Loyola-Future-Engineers/Ion-Thruster-Type-EDH/cad/README.md

# 3-D part models

**Design proposal: not printed, machined, assembled or tested.** Every part is generated
parametrically by `cad/build.py` (manifold3d + trimesh). All dimensions are in millimetres.
The geometry follows the common-supply recommendation in
[`docs/recommendations.md`](../docs/recommendations.md): 40 mm insulating bore, 16 axial
stainless needles on a 30 mm brass ring, 30 mm aluminum tube collectors, gap d = 25 mm from the
needle tips to the collector, and inter-stage spacing s = 75 mm (3d, from the space-charge results).

| Output | What it is |
|---|---|
| `stl/*.stl` | One watertight STL per unique part (13 parts, plus a tie rod per variant) |
| `assembly_2stage.stl`, `assembly_3stage.stl` | Full assemblies on the thrust-test stand |
| `viewer_2stage.html`, `viewer_3stage.html` | Interactive 3-D viewers. Open in a browser and click the legend to hide parts. Needs internet for the Plotly script. |
| `bom_2stage.csv`, `bom_3stage.csv` | Bill of materials: quantity, material, process, envelope, and mass computed from the mesh volume |
| `interference_*.txt` | Pairwise overlap check of every placed part (result: none) |
| `../diagrams/cad_*stage_section.png`, `cad_*stage_exterior.png` | Section through the axis, and exterior render |

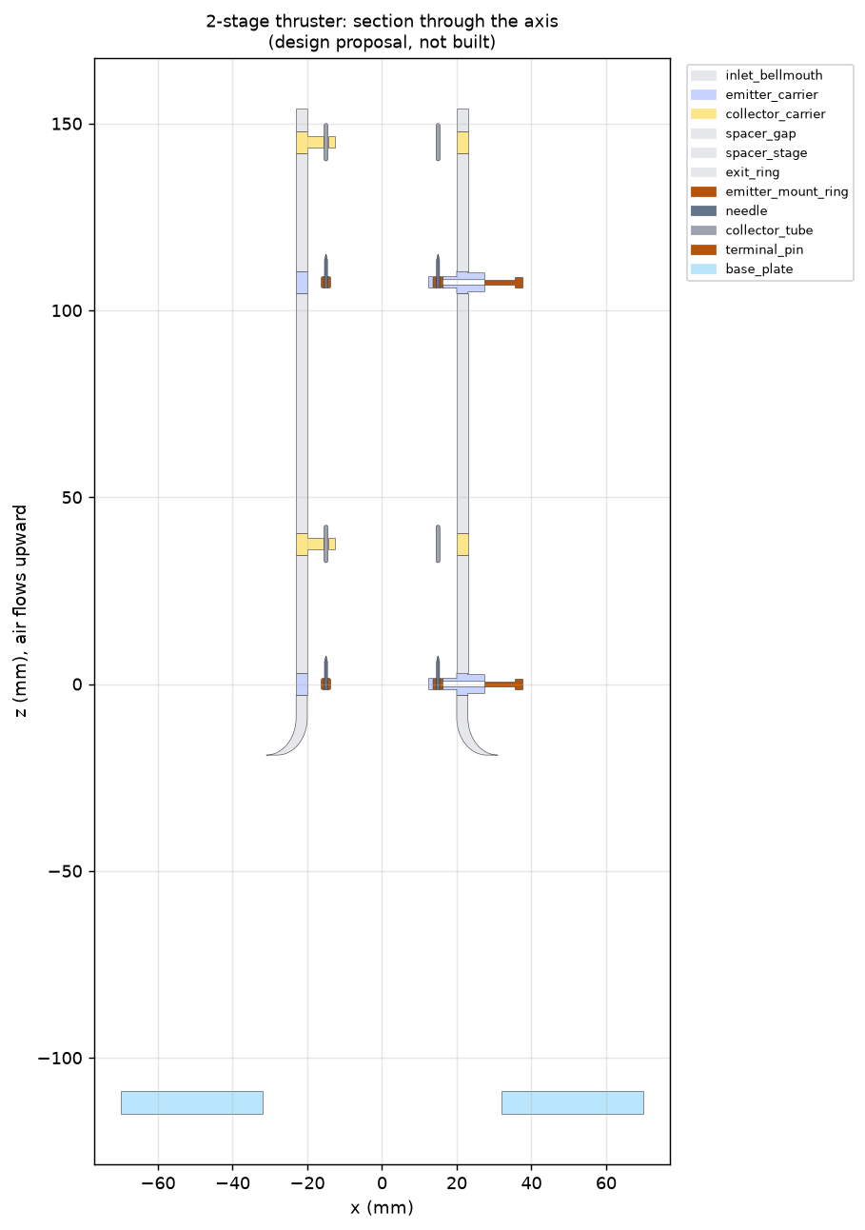
[picture p11: diagrams/cad_2stage_section.png]
section


## Parts

| Part | Qty (2-stage / 3-stage) | Material | Role |
|---|---|---|---|
| `inlet_bellmouth` | 1 / 1 | PETG or ASA (printed) | Rounded inlet, which reduces entry loss. Carries the bottom tie-rod lugs. |
| `emitter_carrier` | 2 / 3 | PETG or ASA | Bore ring with 3 spokes holding the emitter ring. HV wire channel through the 0° spoke to a boss. |
| `emitter_mount_ring` | 2 / 3 | Brass | 30 mm ring, 2.5 × 3 mm section, 16 needle holes; laser/waterjet-cut from 3 mm sheet |
| `needle` | 32 / 48 | Stainless steel (insect pins, bought) | Ø0.5–0.8 mm, 6 mm exposed, about 0.05 mm tip, pointing downstream |
| `collector_carrier` | 2 / 3 | PETG or ASA | Bore ring with 3 spokes gripping the collector tube. Spokes are rotated 60° from the emitter spokes to lengthen surface creepage paths. |
| `collector_tube` | 2 / 3 | Aluminum 6061 | Ø30 mm mean, 1 mm wall, 10 mm long, rounded edges |
| `spacer_gap` | 2 / 3 | PETG or ASA | 31.5 mm bore spacer that sets d. Print several lengths to test other gaps. |
| `spacer_stage` | 1 / 2 | PETG or ASA | 64 mm bore spacer that sets s |
| `exit_ring` | 1 / 1 | PETG or ASA | Top ring with tie-rod lugs |
| `terminal_pin` | 4 / 6 | Brass | HV feed (emitters) and ground return (collectors), on the carrier bosses |
| `tie_rod_*stage` | 3 / 3 | Nylon M3 | Clamp the stack. Insulating. |
| `standoff` | 3 / 3 | PTFE or acetal | 100 mm insulating legs (see `experiments/test_plan.md`) |
| `base_plate` | 1 / 1 | Polycarbonate or acetal | Sits on the balance. A 64 mm hole lets air into the inlet. |

Length and mass (thruster without stand): **173 mm and about 129 g (2-stage); 281 mm and about 202 g
(3-stage)**. Most of the mass is the printed housing; a thinner wall or lighter infill would reduce it.

## Design notes and open issues
- **Creepage:** the surface path from emitter to collector along the printed spokes and bore is
  about 50 mm with the 60° spoke offset, about 2× the 25 mm air gap. That is at the low end of the
  2–3× guideline. If surface tracking or charging shows up, add ribs or grooves to the bore between carriers.
- **Collector section:** the simulations used a 4 mm-thick rounded collector. The CAD tube has a
  1 mm wall, which is lighter and blocks less air, but its sharper edges could start a reverse corona at
  high voltage. Round the edges to at least 0.5 mm radius.
- **HV wiring:** a short bare Ø0.8 mm copper wire runs through the spoke channel (Ø1.4 mm) from the
  terminal pin to the brass ring. It is inside the device at emitter potential, so it needs no
  insulation. The insulated ≥ 30 kV silicone lead from the supply attaches to the terminal pin outside.
- **Needle retention:** drill the holes about 0.02 mm larger than the pins and fix the pins with
  a drop of adhesive. Do not solder stainless.
- **Bore wall:** the space-charge model treats the printed bore as a fully charged-up insulator.
  The first minutes of operation, while it charges, will behave differently.

## Rebuild / change a parameter
```bash
.venv/bin/python cad/build.py     # edit the Cfg dataclass (gap, spacing, pins, bore...) first
```
