Loyola-Future-Engineers/Ion-Thruster-Type-EDH/charts/B5_breakdown_margin.png

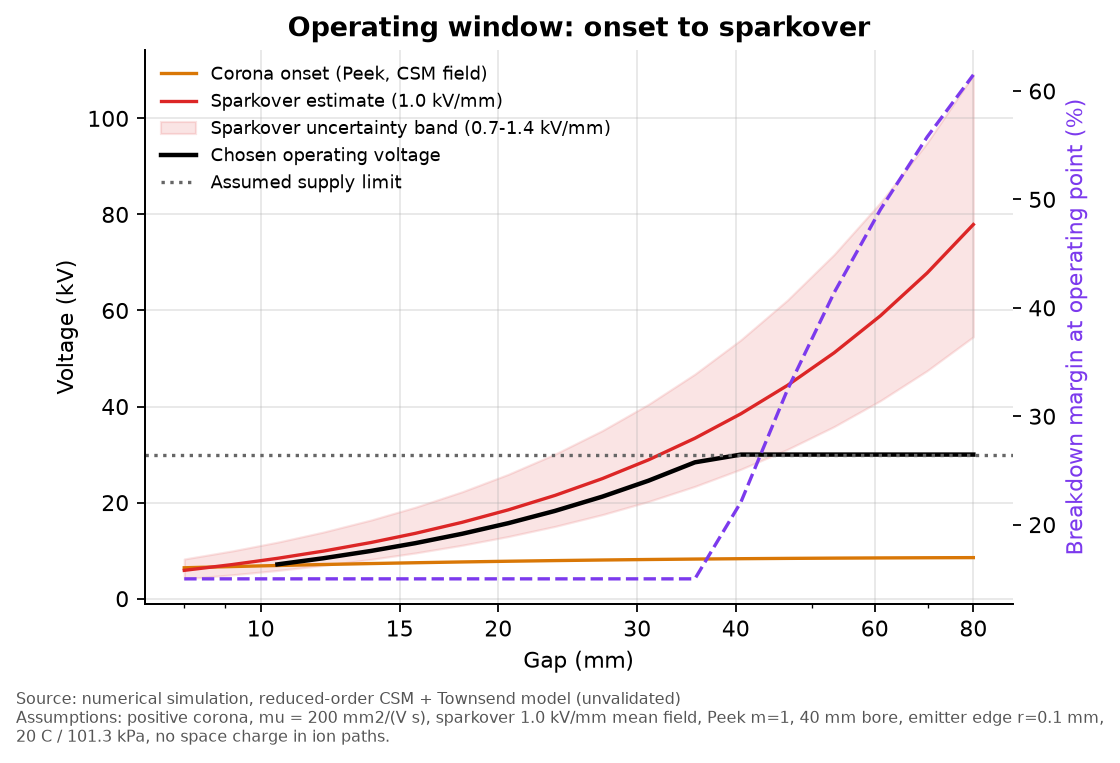
charts/B5_breakdown_margin.png
