Loyola-Future-Engineers/Ion-Thruster-Type-EDH/charts/B6_gap_pattern_comparison.png

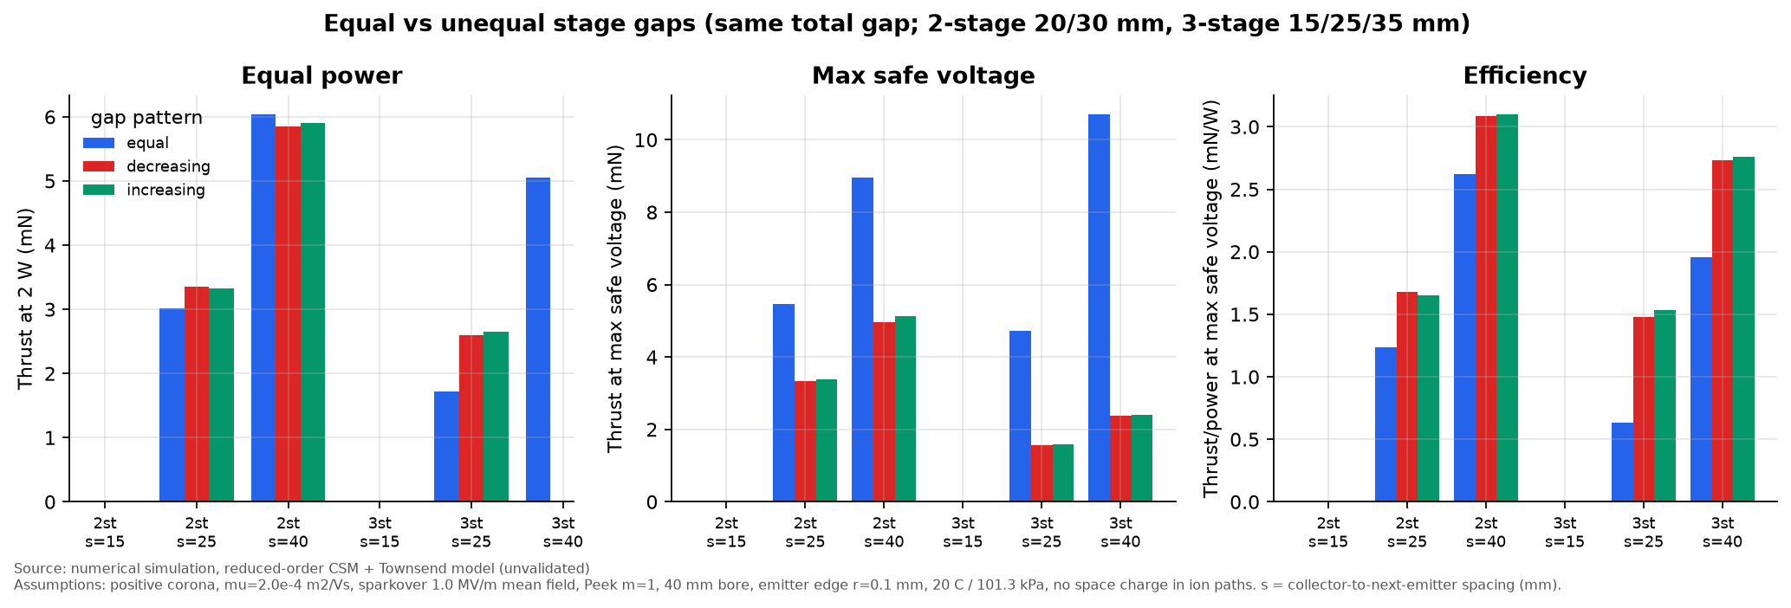
charts/B6_gap_pattern_comparison.png
