Loyola-Future-Engineers/Ion-Thruster-Type-EDH/charts/B6_gap_patterns_common_supply.png

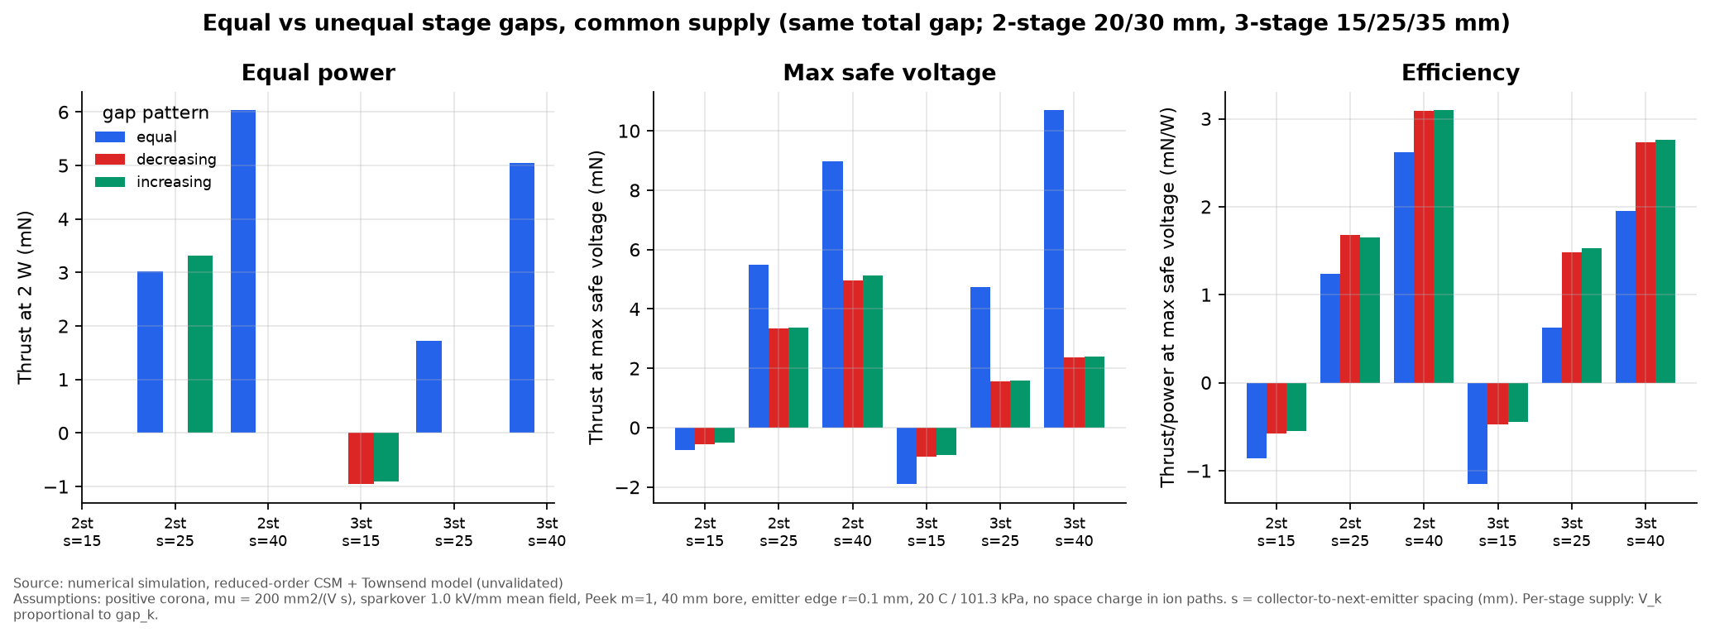
charts/B6_gap_patterns_common_supply.png
