Loyola-Future-Engineers/Ion-Thruster-Type-EDH/charts/B7_backflow_by_stage.png

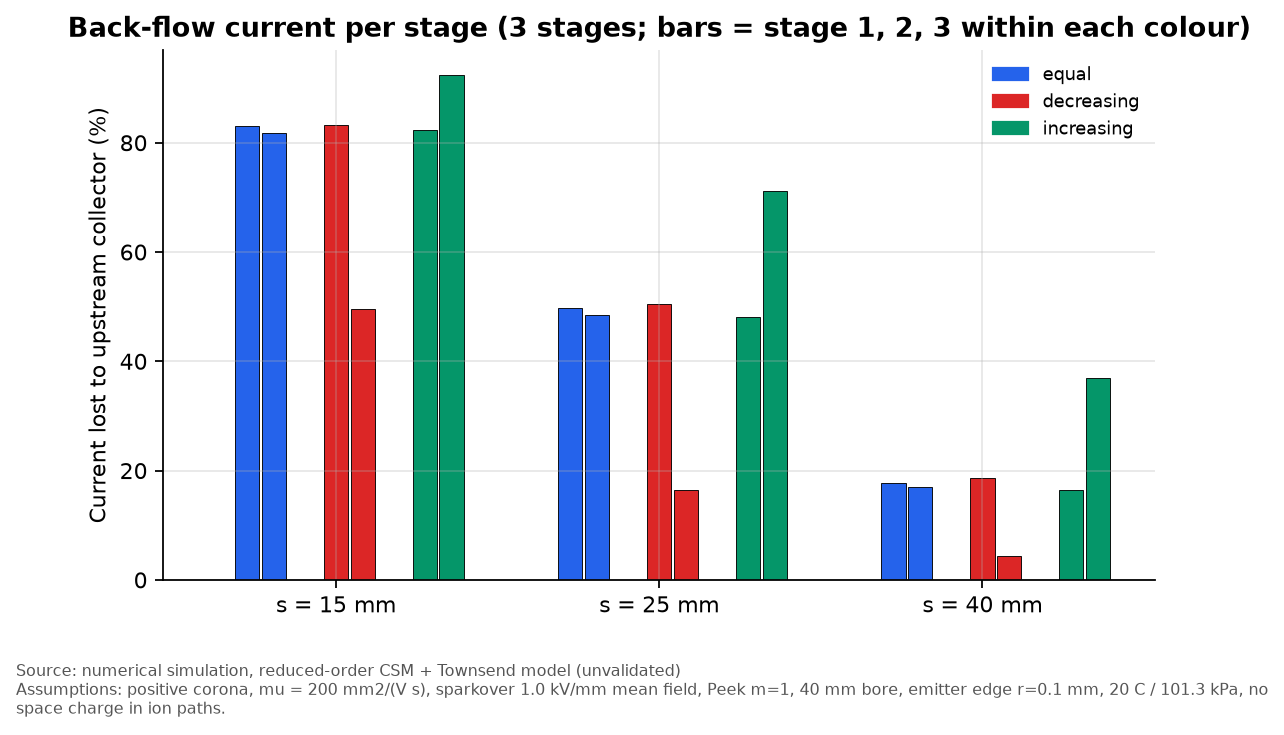
charts/B7_backflow_by_stage.png
