Loyola-Future-Engineers/Ion-Thruster-Type-EDH/charts/B9_independent_gap_search.png

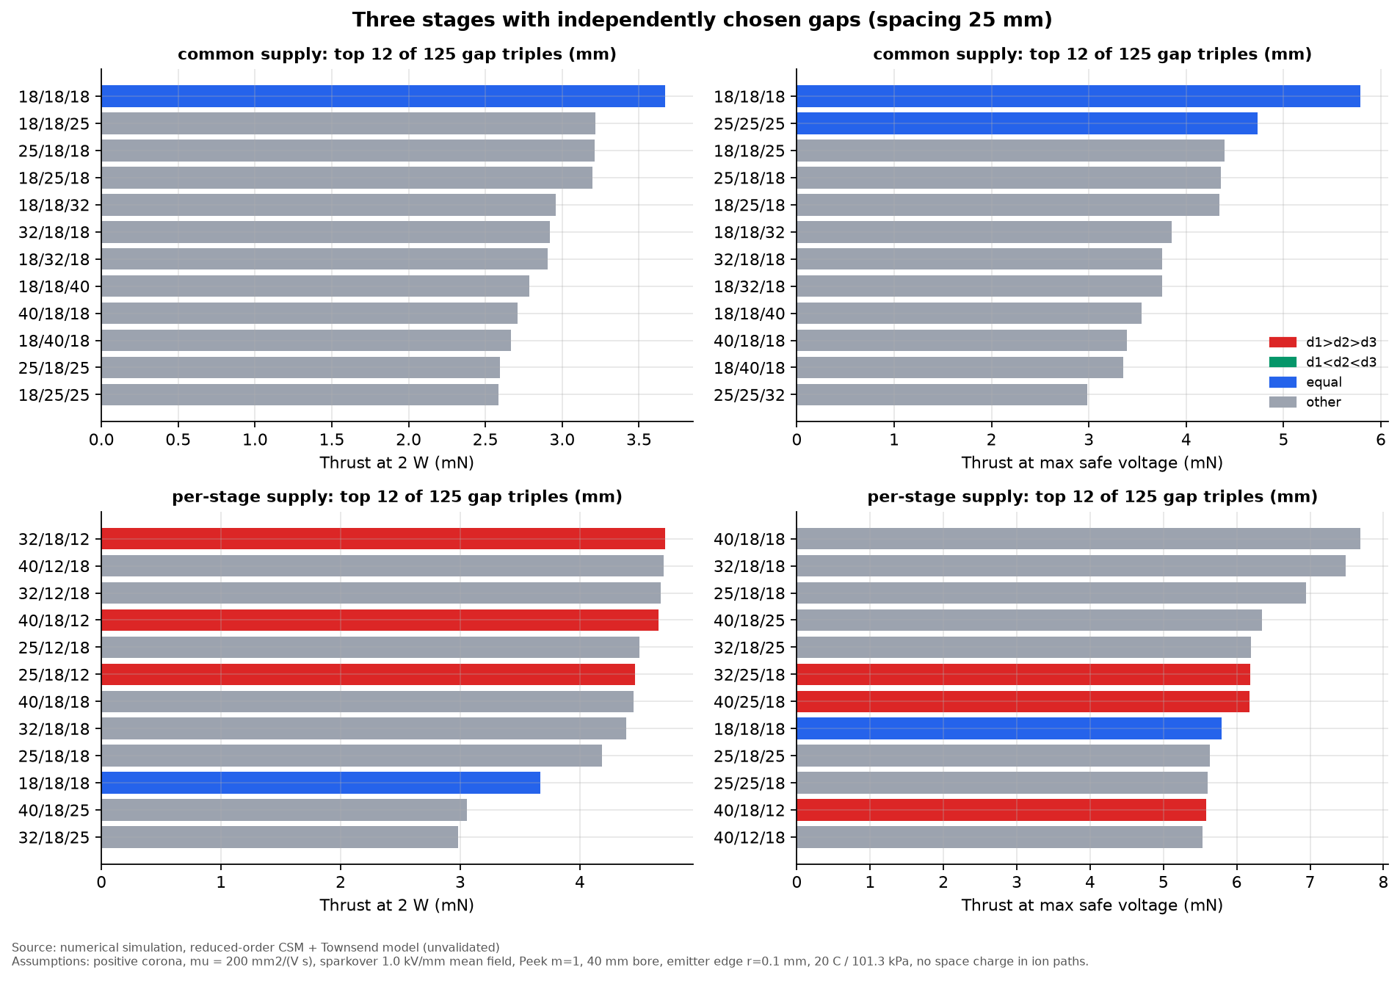
charts/B9_independent_gap_search.png
