Loyola-Future-Engineers/Ion-Thruster-Type-EDH/charts/F2_stage_count_equal_power.png

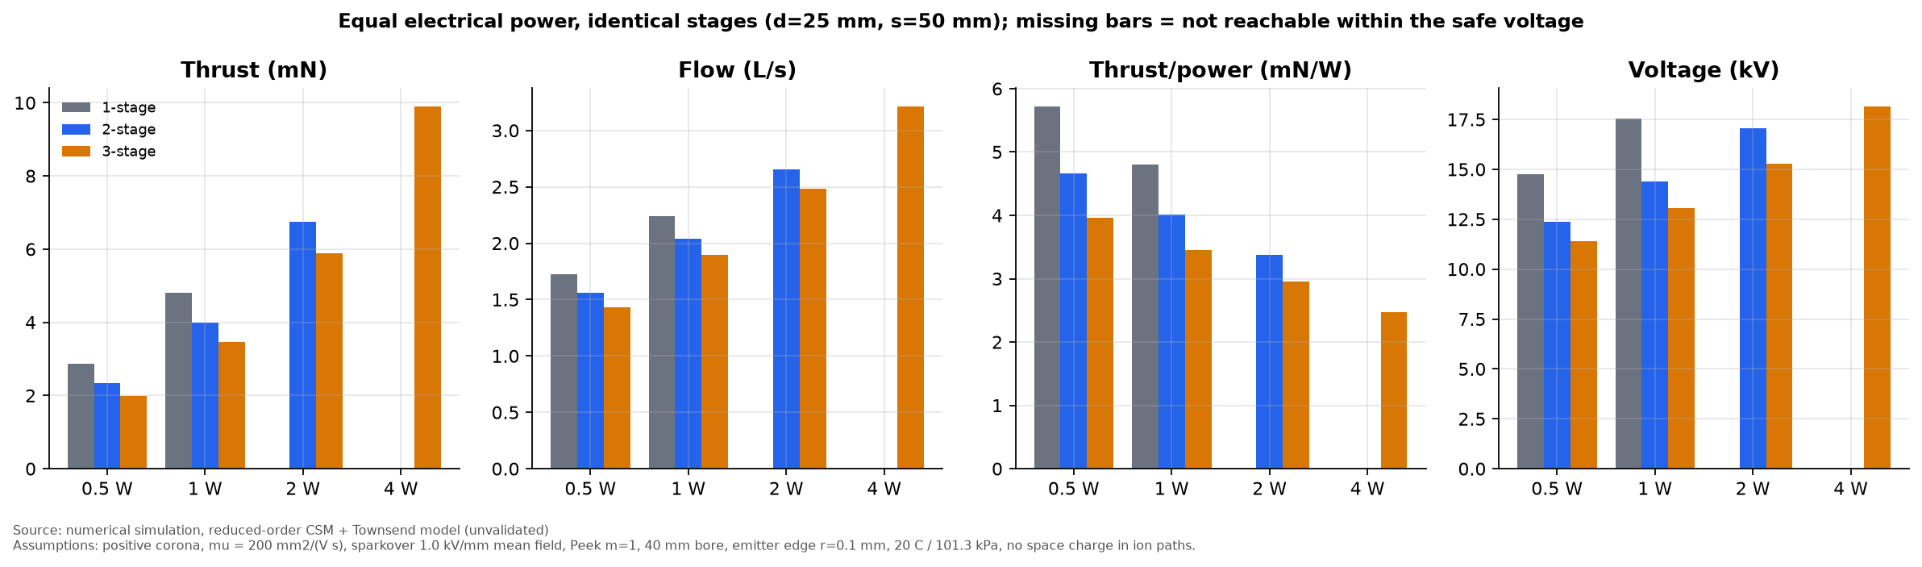
charts/F2_stage_count_equal_power.png
