Loyola-Future-Engineers/Ion-Thruster-Type-EDH/charts/F3_stage_count_vs_power.png

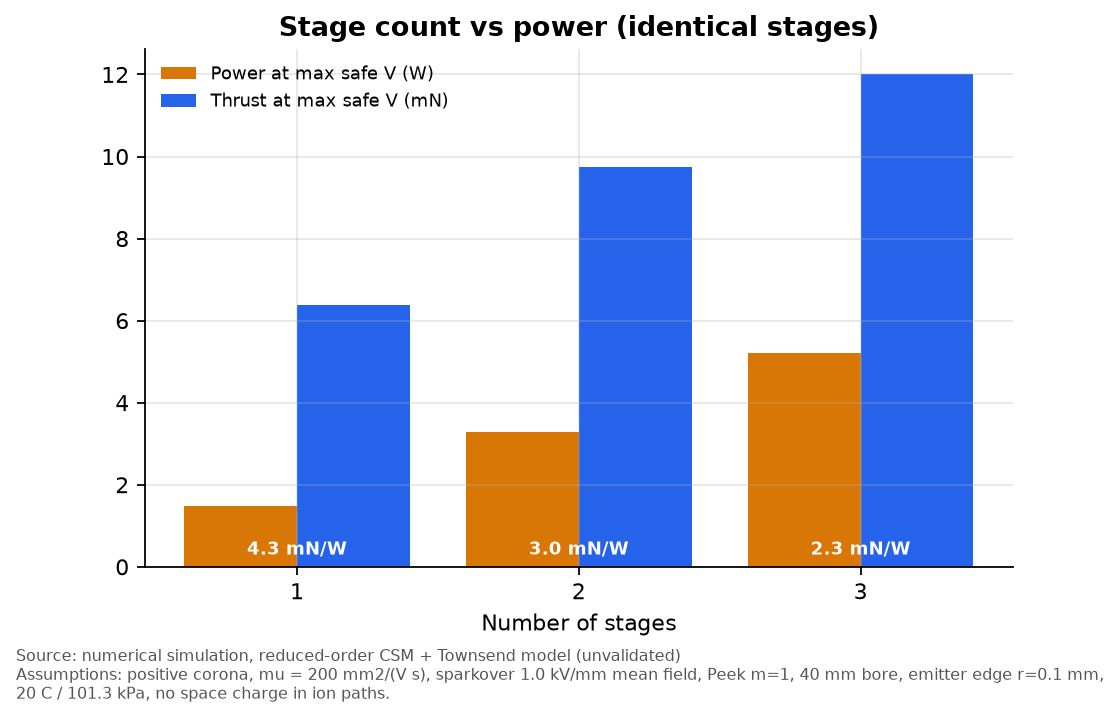
charts/F3_stage_count_vs_power.png
