Loyola-Future-Engineers/Ion-Thruster-Type-EDH/diagrams/cad_3stage_exterior.png

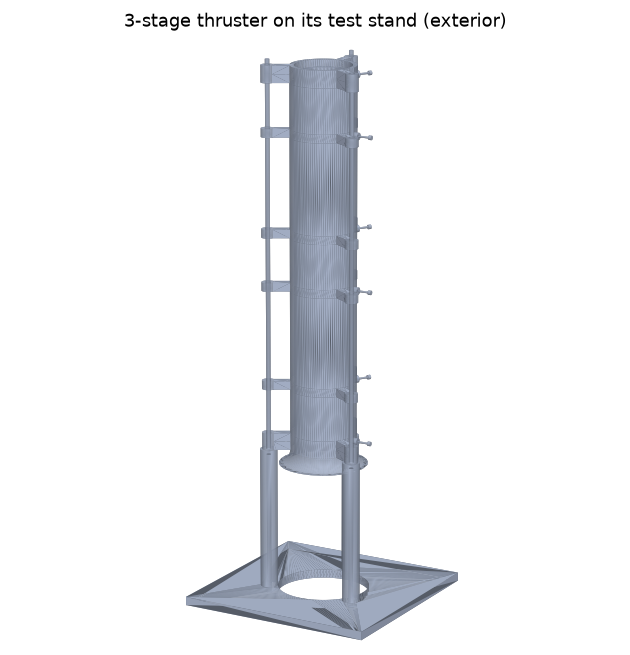
diagrams/cad_3stage_exterior.png
