Loyola-Future-Engineers/Ion-Thruster-Type-EDH/diagrams/cad_3stage_section.png

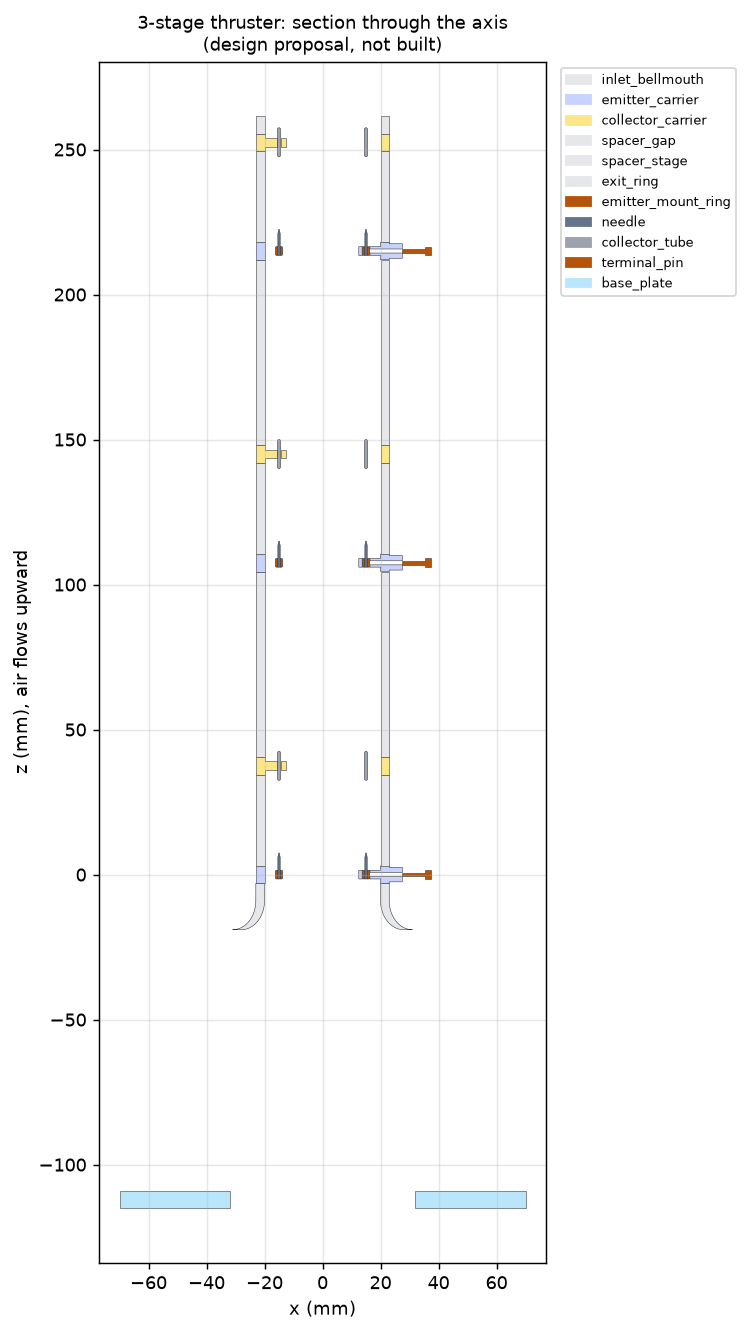
diagrams/cad_3stage_section.png
