Loyola-Future-Engineers/Ion-Thruster-Type-EDH/diagrams/pin_orientations.png

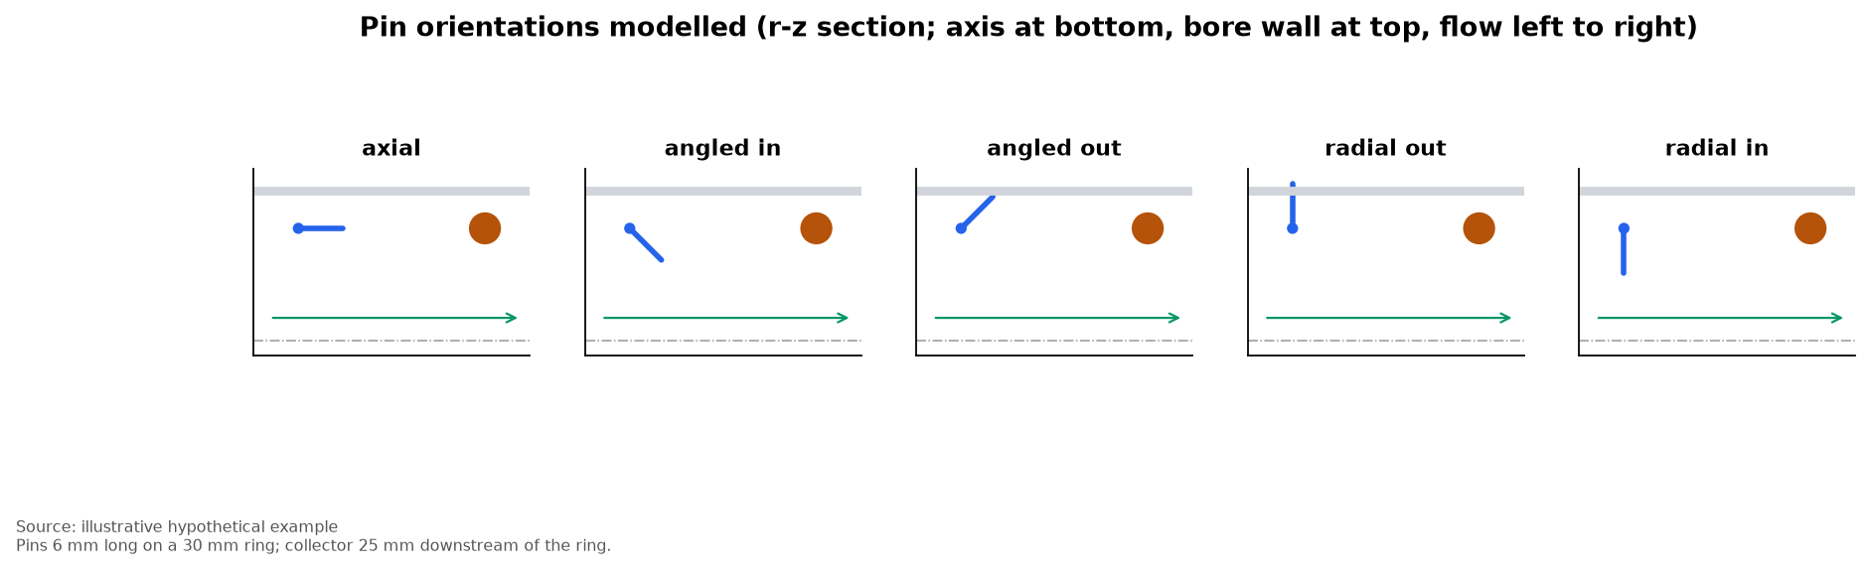
diagrams/pin_orientations.png
