Loyola-Future-Engineers/Ion-Thruster-Type-EDH/diagrams/pin_ring_front.png

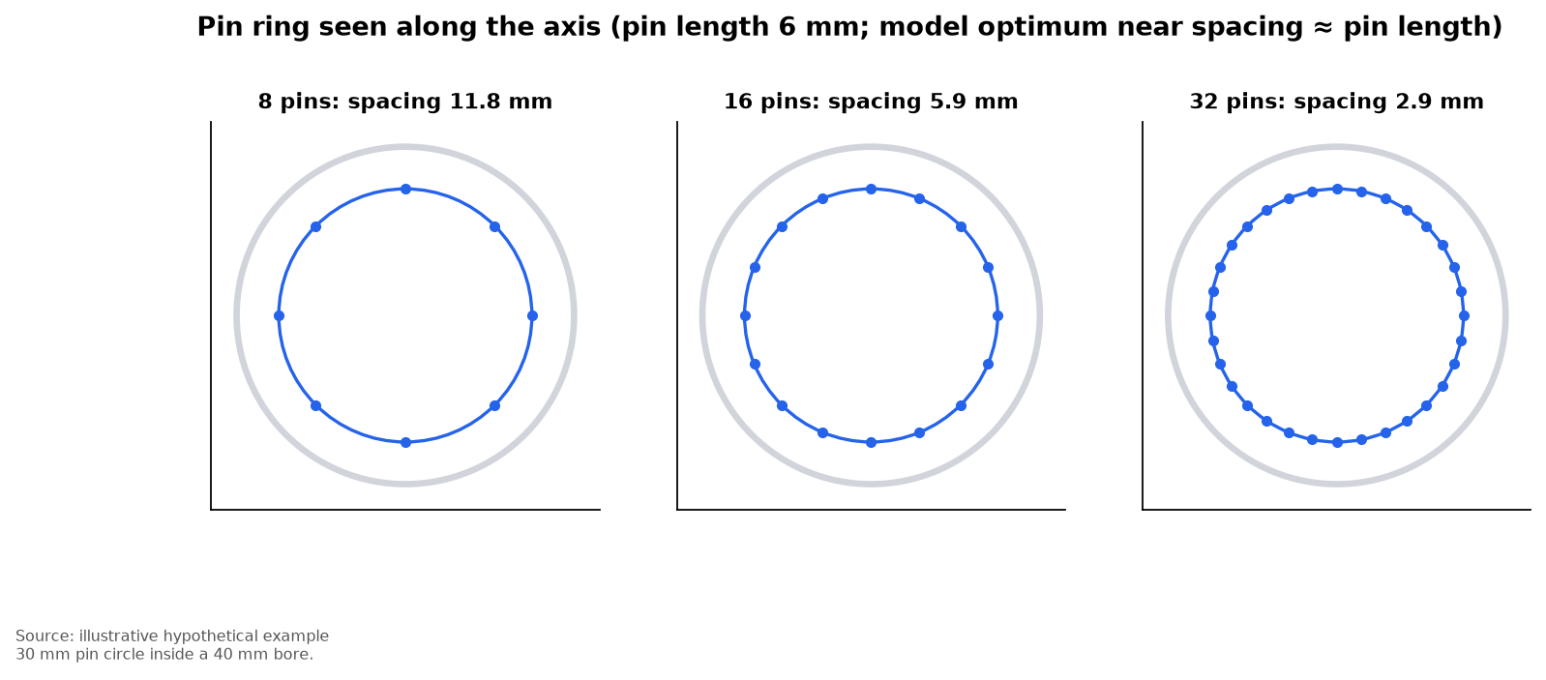
diagrams/pin_ring_front.png
