Loyola-Future-Engineers/Ion-Thruster-Type-EDH/diagrams/three_stage_section.png

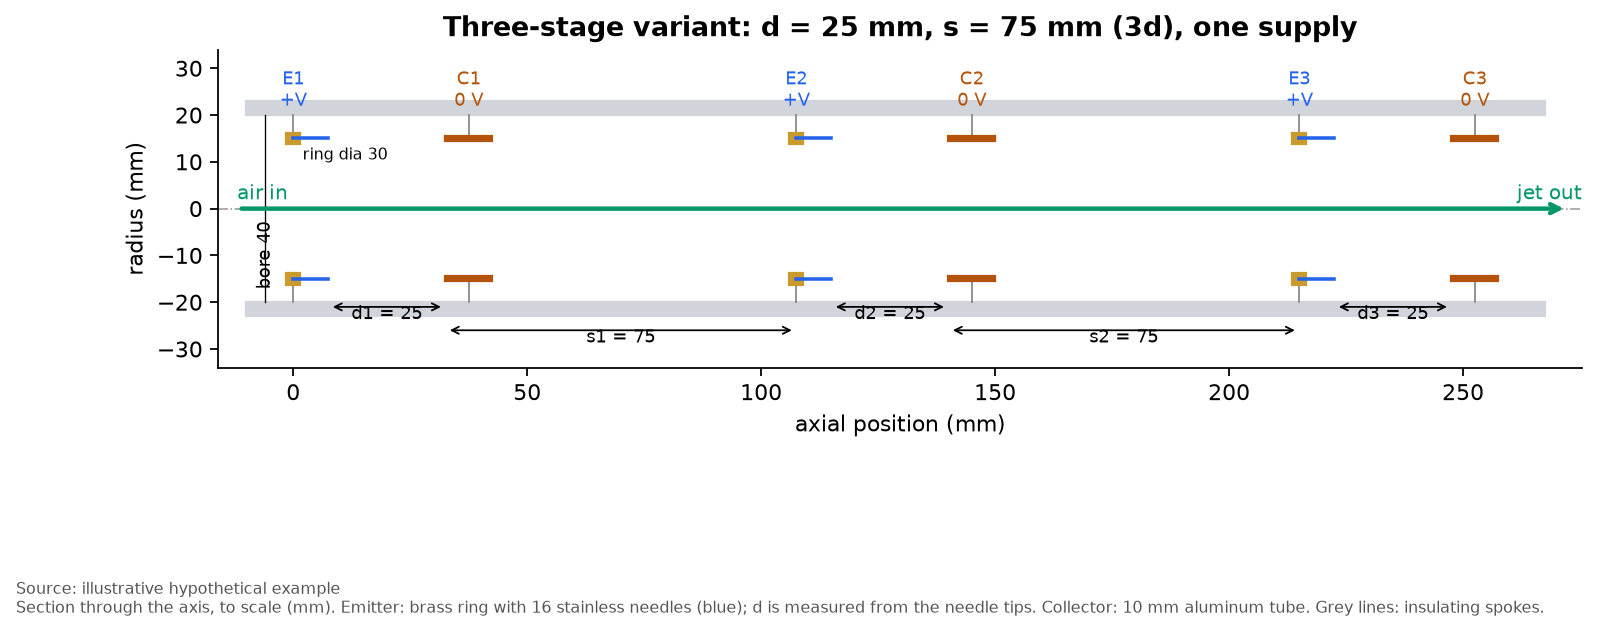
diagrams/three_stage_section.png
