Loyola-Future-Engineers/Ion-Thruster-Type-EDH/prototypes/P1_parts_list.csv

part | file | qty | material | key_dimensions_mm | envelope_mm | mass_each_g | mass_total_g | process
Inlet bellmouth | cad/stl/inlet_bellmouth.stl | 1 | PETG or ASA | Ø40 bore, Ø62 lip, 16 tall, 3 wall | 74.8 x 73.5 x 16.0 | 11.39 | 11.39 | 3-D print
Emitter carrier | cad/stl/emitter_carrier.stl | 2 | PETG or ASA | Ø40 / Ø46 ring, 6 thick, 3 spokes 2.4 wide, Ø1.4 wire channel | 74.8 x 66.0 x 6.0 | 6.05 | 12.11 | 3-D print
Emitter mounting ring | cad/stl/emitter_mount_ring.stl | 2 | Brass | Ø30 mean, 2.5 × 3 section, 16 holes Ø0.82 | 32.5 x 32.5 x 3.0 | 5.67 | 11.33 | Laser/waterjet-cut from 3 mm brass sheet, or machine
Emitter needle | cad/stl/needle.stl | 32 | Stainless steel 304 | Ø0.8 × 9 (6 exposed), tip radius ≈ 0.05 | 0.8 x 0.8 x 9.0 | 0.03 | 1.03 | Buy: stainless insect pins Ø0.5–0.8 (tip ≈ 0.05)
Gap spacer | cad/stl/spacer_gap.stl | 2 | PETG or ASA | Ø40 / Ø46 tube, 31.5 long | 46.0 x 46.0 x 31.5 | 16.2 | 32.4 | 3-D print
Collector carrier | cad/stl/collector_carrier.stl | 2 | PETG or ASA | Ø40 / Ø46 ring, 6 thick, 3 spokes (60° offset) | 74.8 x 66.0 x 6.0 | 6.09 | 12.18 | 3-D print
Collector tube | cad/stl/collector_tube.stl | 2 | Aluminum 6061 | Ø30 mean, 1 wall, 10 long, edges R0.5 | 31.0 x 31.0 x 10.0 | 2.49 | 4.97 | Cut from Ø30–32 × 1 tube, deburr, round edges
Stage spacer | cad/stl/spacer_stage.stl | 1 | PETG or ASA | Ø40 / Ø46 tube, 64.0 long | 46.0 x 46.0 x 64.0 | 32.92 | 32.92 | 3-D print
Exit ring | cad/stl/exit_ring.stl | 1 | PETG or ASA | Ø40 / Ø46 ring, 6 thick | 74.8 x 66.0 x 6.0 | 5.83 | 5.83 | 3-D print
Terminal pin | cad/stl/terminal_pin.stl | 4 | Brass | Ø1.2 × 8 shank, Ø3 head | 3.0 x 3.0 x 10.0 | 0.19 | 0.77 | Brass M2 screw or 2 mm banana jack
Tie rod | cad/stl/tie_rod_2stage.stl | 3 | Nylon M3 | M3 × 171 | 3.0 x 3.0 x 171.0 | 1.37 | 4.12 | Buy, cut to length
Insulating standoff | cad/stl/standoff.stl | 3 | PTFE or acetal | Ø12 × 100, M3 tapped through | 12.0 x 12.0 x 100.0 | 23.27 | 69.82 | Machine/buy
Base plate | cad/stl/base_plate.stl | 1 | Polycarbonate or acetal | 140 × 140 × 6, Ø64 air hole | 140.0 x 140.0 x 6.0 | 117.78 | 117.78 | Laser cut / machine
