Loyola-Future-Engineers/Ion-Thruster-Type-EDH/cad/assembly_2stage.stl

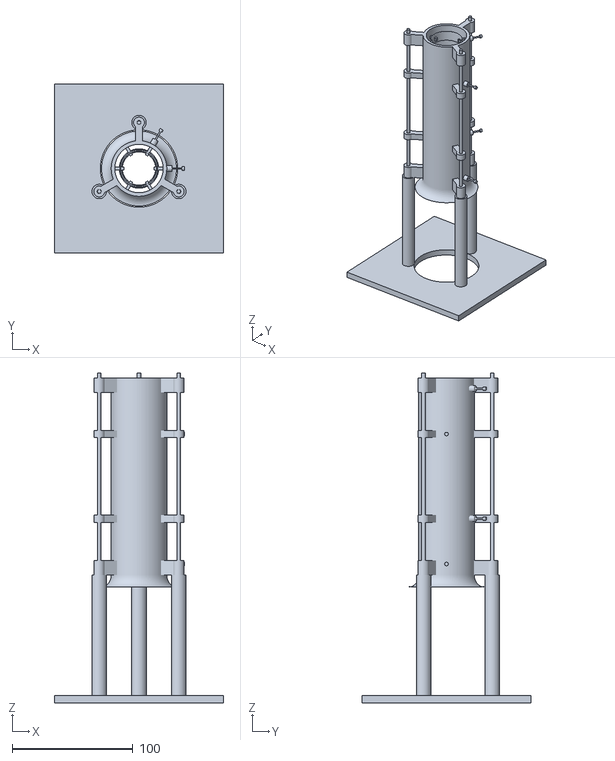
[picture p38: CAD file, 2026-10-29]
cad/assembly_2stage.stl
140.0 x 140.0 x 273.0
