Loyola-Future-Engineers/Ion-Thruster-Type-EDH/cad/assembly_3stage.stl

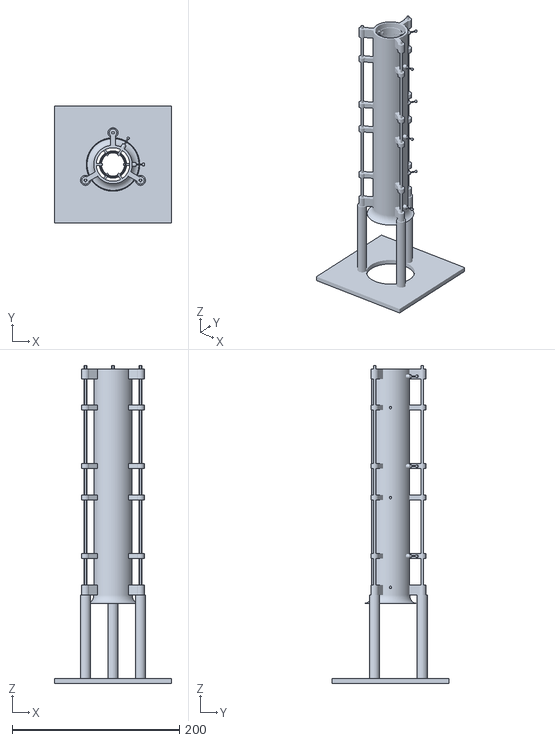
[picture p39: CAD file, 2026-10-29]
cad/assembly_3stage.stl
140.0 x 140.0 x 380.5
