Loyola-Future-Engineers/Ion-Thruster-Type-EDH/cad/stl/tie_rod_2stage.stl

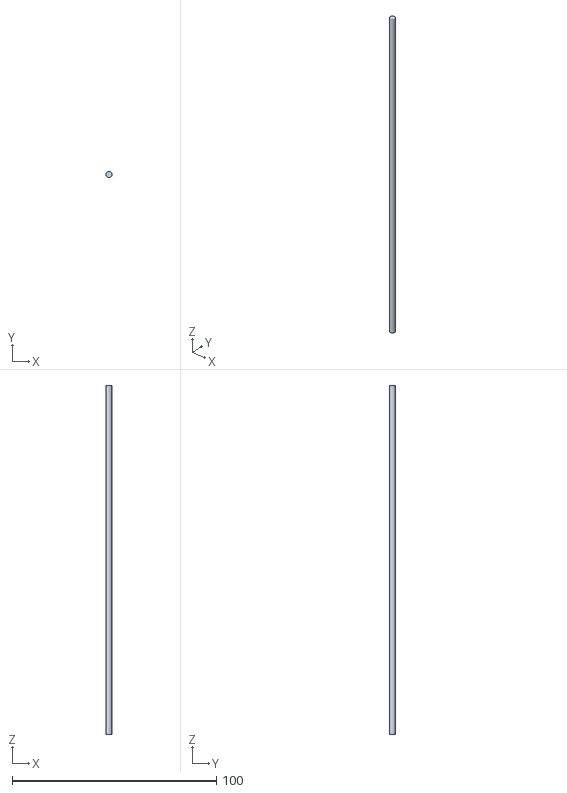
[picture p40: CAD file, 2026-10-29]
cad/stl/tie_rod_2stage.stl
3.00 x 3.00 x 171.0
