Loyola-Future-Engineers/Ion-Thruster-Type-EDH/prototypes/P1_exploded.stl

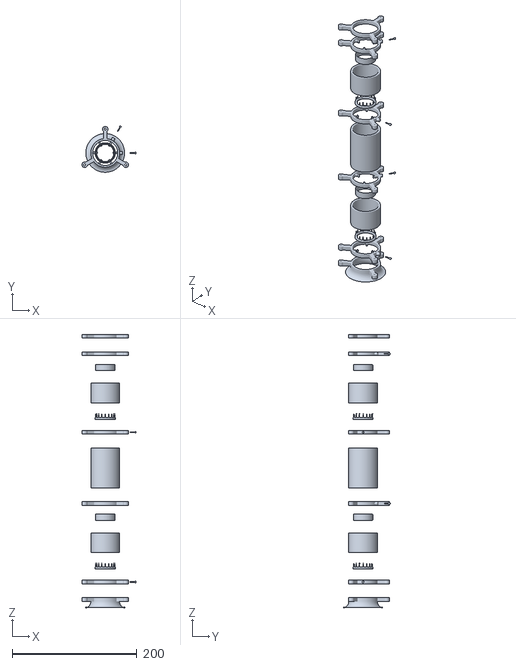
[picture p41: CAD file, 2026-10-29]
prototypes/P1_exploded.stl
86.9 x 74.6 x 437.0
