Loyola-Future-Engineers/Ion-Thruster-Type-EDH/cad/stl/tie_rod_3stage.stl

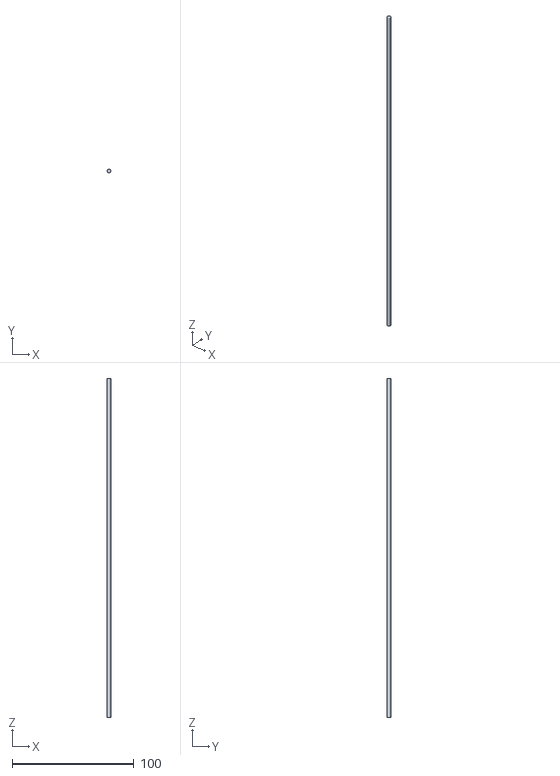
[picture p42: CAD file, 2026-10-29]
cad/stl/tie_rod_3stage.stl
3.00 x 3.00 x 278.5
