Loyola-Future-Engineers/Ion-Thruster-Type-EDH/prototypes/P1x3_merge_joint.stl

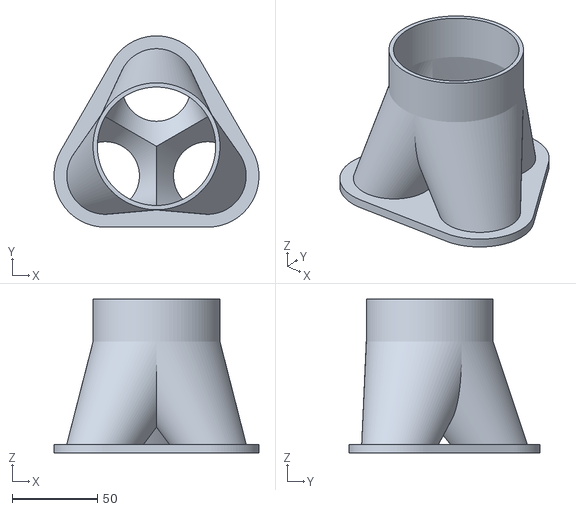
[picture p43: CAD file, 2026-10-29]
prototypes/P1x3_merge_joint.stl
120.0 x 112.0 x 90.0
