Loyola-Future-Engineers/Ion-Thruster-Type-EDH/cad/stl/spacer_gap.stl

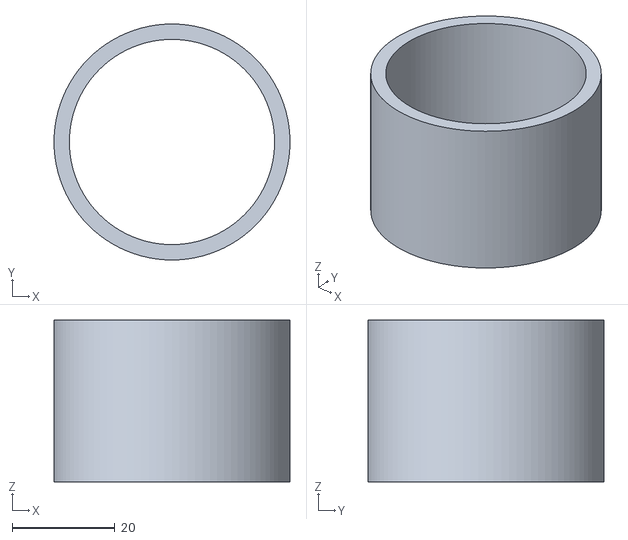
[picture p44: CAD file, 2026-10-29]
cad/stl/spacer_gap.stl
46.0 x 46.0 x 31.5
