Loyola-Future-Engineers/Ion-Thruster-Type-EDH/prototypes/P1x3_top_plate.stl

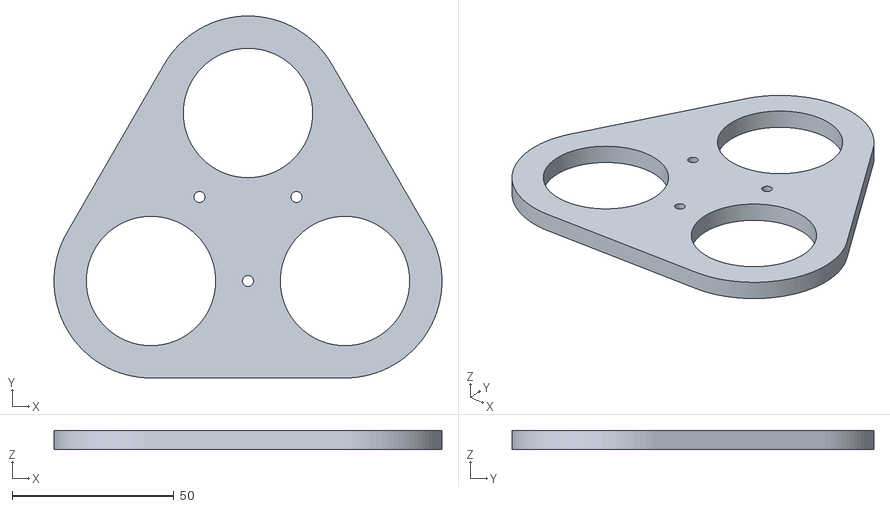
[picture p45: CAD file, 2026-10-29]
prototypes/P1x3_top_plate.stl
120.0 x 112.0 x 6.00
