Loyola-Future-Engineers/Ion-Thruster-Type-EDH/cad/stl/standoff.stl

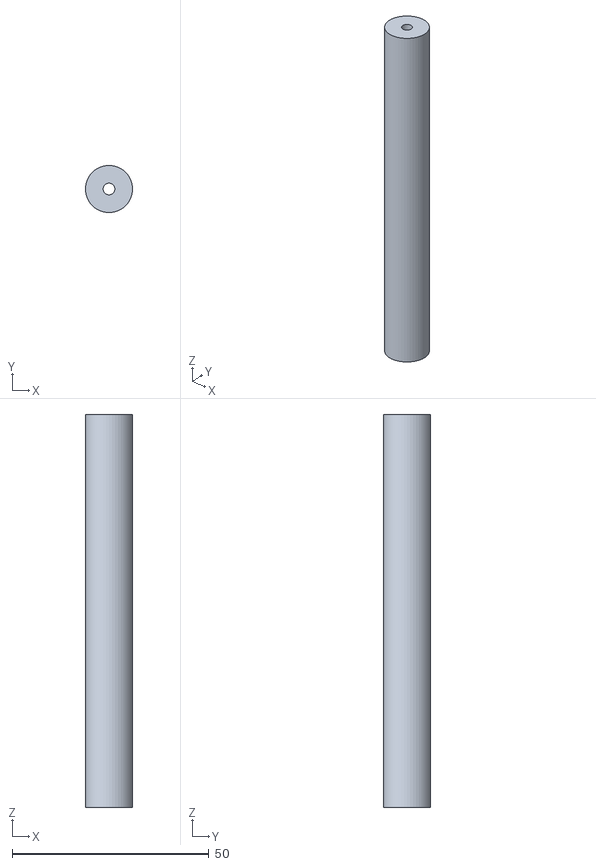
[picture p46: CAD file, 2026-10-29]
cad/stl/standoff.stl
12.0 x 12.0 x 100.0
