Loyola-Future-Engineers/Ion-Thruster-Type-EDH/prototypes/P1x3_cluster_with_joint.stl

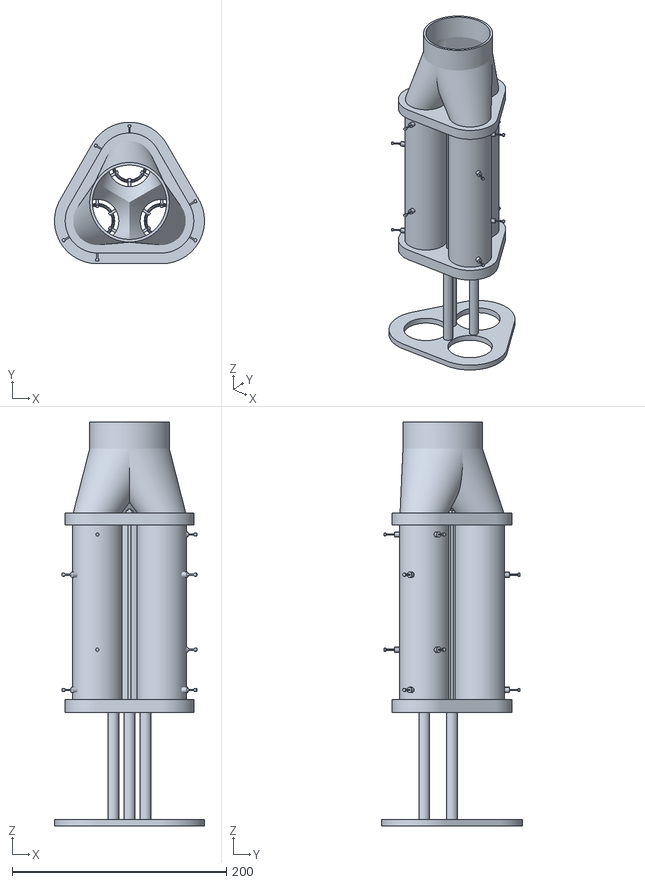
[picture p47: CAD file, 2026-10-29]
prototypes/P1x3_cluster_with_joint.stl
140.0 x 132.0 x 377.0
