Loyola-Future-Engineers/Ion-Thruster-Type-EDH/cad/stl/emitter_mount_ring.stl

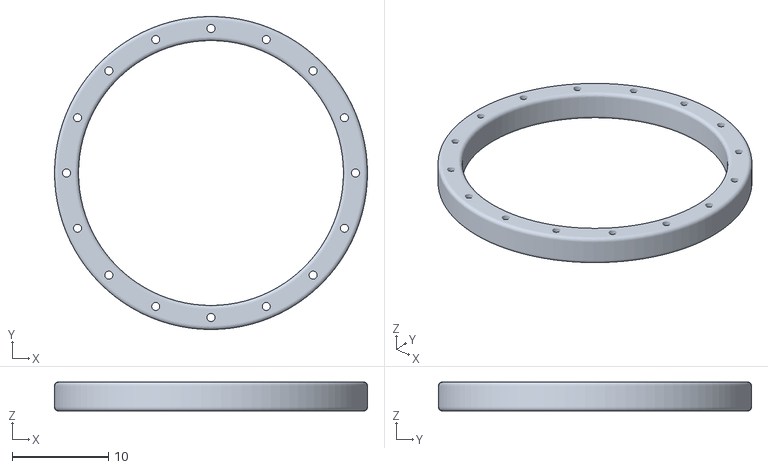
[picture p48: CAD file, 2026-10-29]
cad/stl/emitter_mount_ring.stl
32.5 x 32.5 x 3.00
