Loyola-Future-Engineers/Ion-Thruster-Type-EDH/prototypes/P1x3_cluster.stl

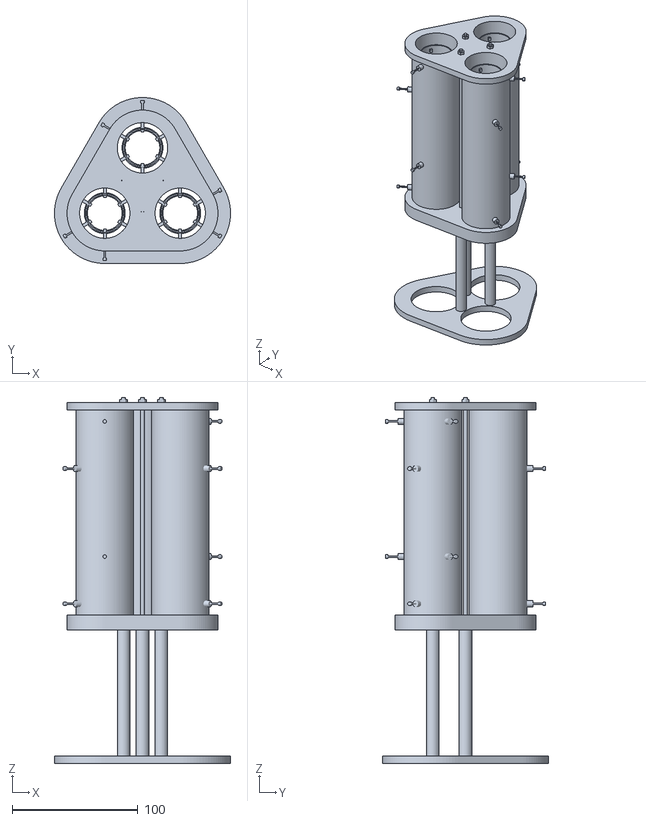
[picture p49: CAD file, 2026-10-29]
prototypes/P1x3_cluster.stl
140.0 x 132.0 x 291.0
