Loyola-Future-Engineers/Ion-Thruster-Type-EDH/cad/stl/inlet_bellmouth.stl

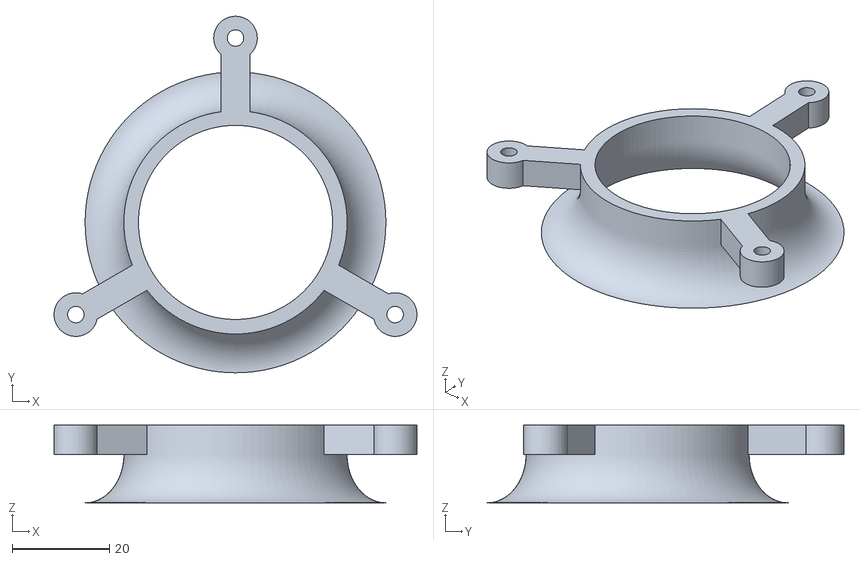
[picture p50: CAD file, 2026-10-29]
cad/stl/inlet_bellmouth.stl
74.8 x 73.5 x 16.0
