Loyola-Future-Engineers/Ion-Thruster-Type-EDH/prototypes/P1x3_inlet_plate.stl

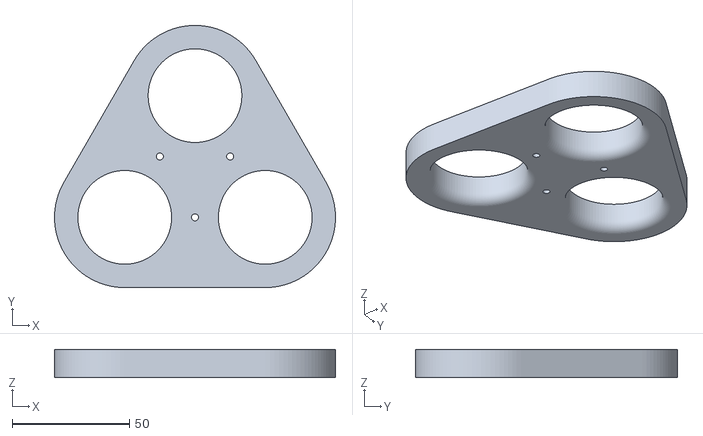
[picture p51: CAD file, 2026-10-29]
prototypes/P1x3_inlet_plate.stl
120.0 x 112.0 x 12.0
