Loyola-Future-Engineers/Ion-Thruster-Type-EDH/cad/stl/terminal_pin.stl

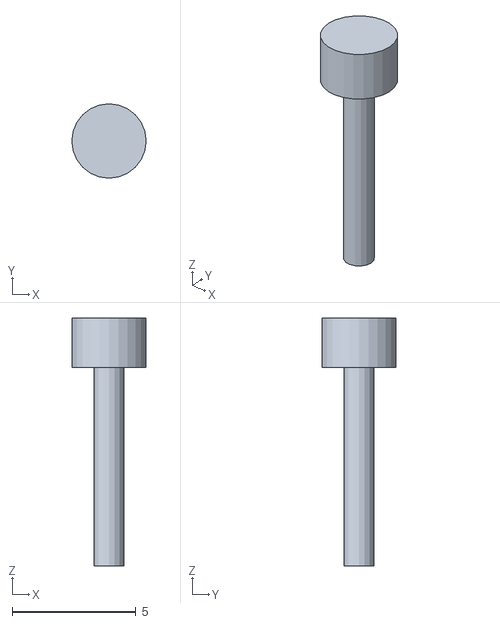
[picture p52: CAD file, 2026-10-29]
cad/stl/terminal_pin.stl
3.00 x 3.00 x 10.0
