Loyola-Future-Engineers/Ion-Thruster-Type-EDH/cad/stl/needle.stl

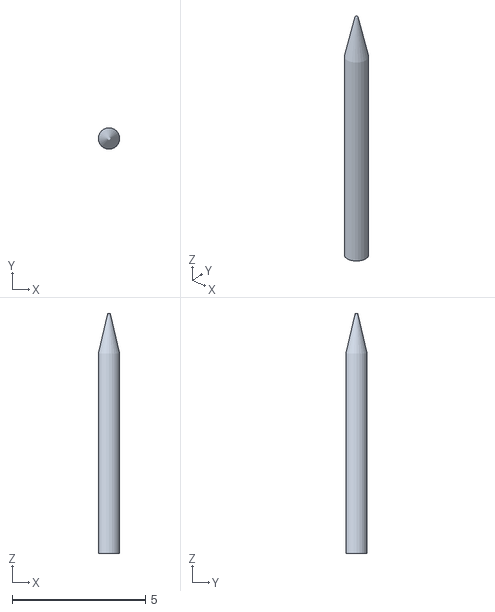
[picture p53: CAD file, 2026-10-29]
cad/stl/needle.stl
0.8 x 0.8 x 9.00
