Loyola-Future-Engineers/Ion-Thruster-Type-EDH/cad/stl/spacer_stage.stl

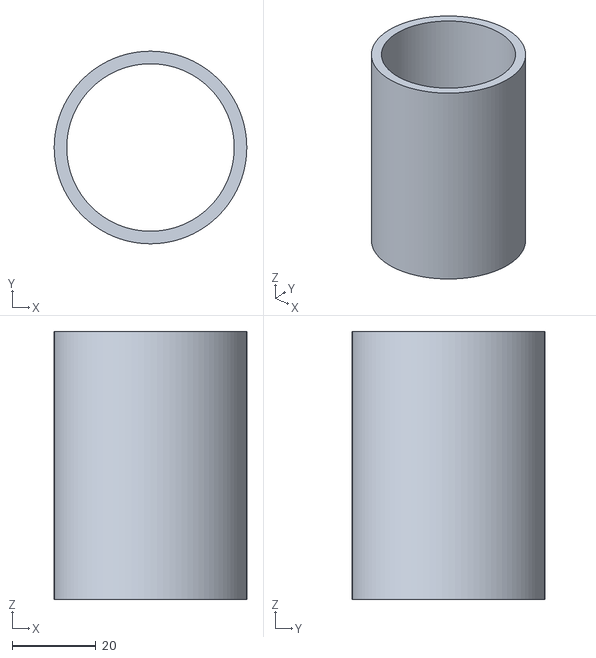
[picture p54: CAD file, 2026-10-29]
cad/stl/spacer_stage.stl
46.0 x 46.0 x 64.0
