Loyola-Future-Engineers/Ion-Thruster-Type-EDH/cad/stl/base_plate.stl

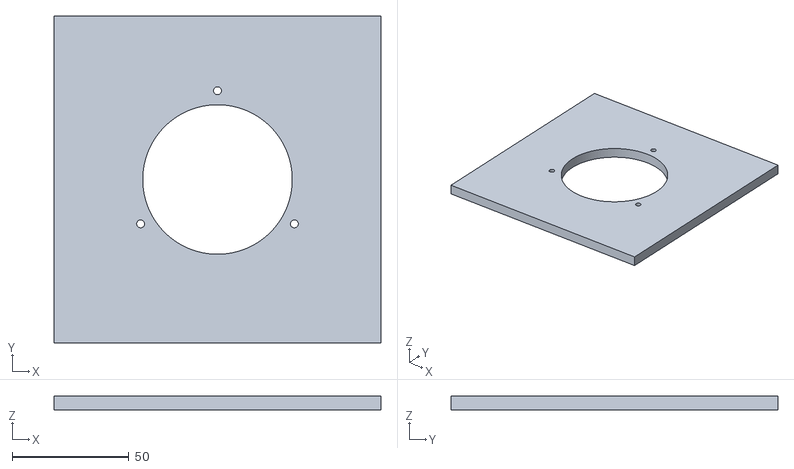
[picture p55: CAD file, 2026-10-29]
cad/stl/base_plate.stl
140.0 x 140.0 x 6.00
