Loyola-Future-Engineers/Ion-Thruster-Type-EDH/cad/stl/collector_tube.stl

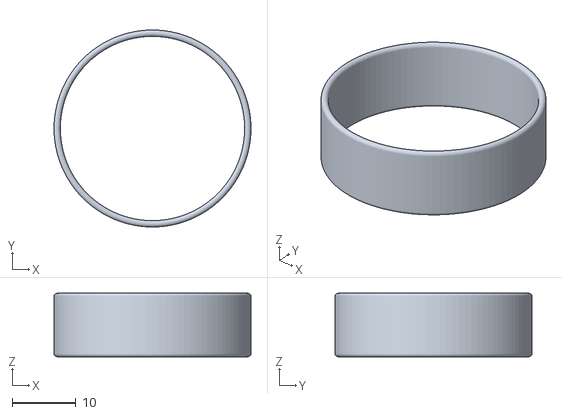
[picture p56: CAD file, 2026-10-29]
cad/stl/collector_tube.stl
31.0 x 31.0 x 10.0
