Loyola-Future-Engineers/Ion-Thruster-Type-EDH/cad/stl/emitter_carrier.stl

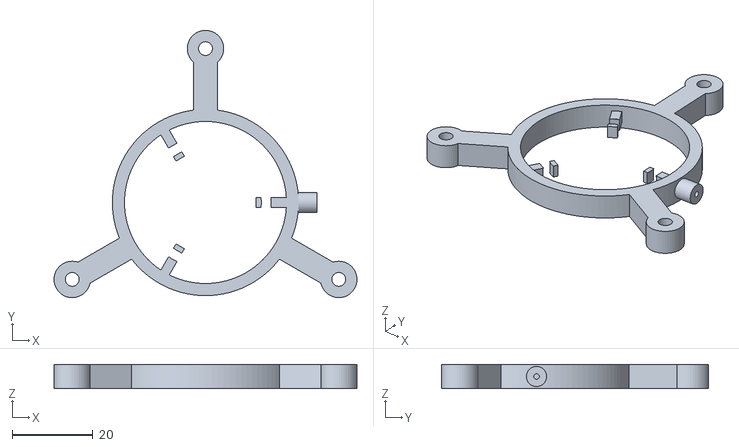
[picture p57: CAD file, 2026-10-29]
cad/stl/emitter_carrier.stl
74.8 x 66.0 x 6.00
