Loyola-Future-Engineers/Ion-Thruster-Type-EDH/cad/stl/exit_ring.stl

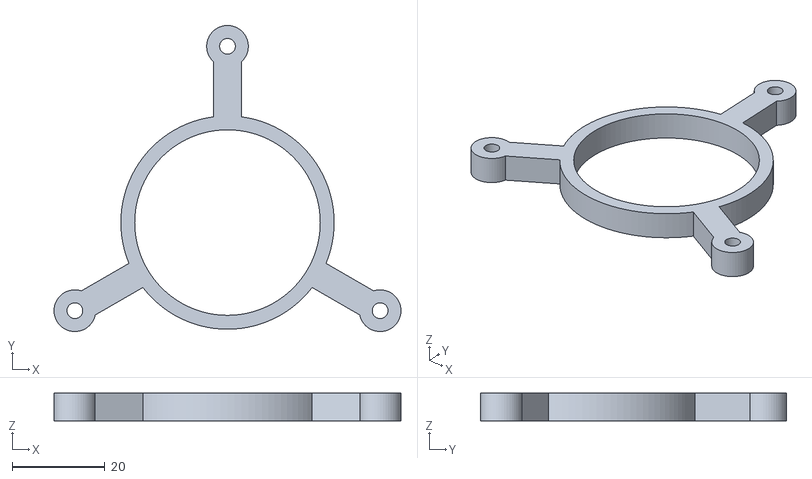
[picture p58: CAD file, 2026-10-29]
cad/stl/exit_ring.stl
74.8 x 66.0 x 6.00
