Loyola-Future-Engineers/Ion-Thruster-Type-EDH/(list of files, cad)

Other CAD files:
cad/stl/collector_carrier.stl
