Loyola-Future-Engineers/Ion-Thruster-Type-EDH/data/phase_h_coax_validation.csv

V_kV | solver_uA_per_mm | exact_uA_per_mm | townsend_uA_per_mm
9.0 | 0.0 | 0.0 | 0.0
12.0 | 1.0058131403527535 | 1.0244736289674408 | 0.8484745969813884
15.0 | 2.7072542882044246 | 2.737818218724575 | 2.1478332498100396
18.0 | 5.0246965796412395 | 5.055317009126258 | 3.882087904072012
21.0 | 7.9277166562759325 | 7.950795293144411 | 6.051238559767306
24.0 | 11.403934652629307 | 11.409793355423794 | 8.655285216895921
27.0 | 15.443646023849958 | 15.42304894587104 | 11.69422787545786
30.0 | 20.040569385532706 | 19.984106054546288 | 15.168066535453118
