Loyola-Future-Engineers/Ion-Thruster-Type-EDH/data/verification_device_convergence.csv

kind | value | thrust_mN | backflow | V0_kV
n_lines | 16 | 8.77613814258925 | 0.10725439445585967 | 8.223721557853128
n_lines | 24 | 9.104697825034036 | 0.08072497434161231 | 8.223721557853128
n_lines | 32 | 9.291088620527784 | 0.08162703211087569 | 8.223721557853128
n_lines | 48 | 9.130531521208184 | 0.09058565283513512 | 8.223721557853128
n_lines | 64 | 9.108053272438795 | 0.08830598874790888 | 8.223721557853128
n_lines | 96 | 9.171073840383027 | 0.08618969267262011 | 8.223721557853128
n_per | 16 | 9.130424678420702 | 0.09058570395224994 | 8.223848289824657
n_per | 24 | 9.13045645452614 | 0.0905856964815813 | 8.223810281564345
n_per | 32 | 9.130525925698489 | 0.09058558535334908 | 8.223729512427342
n_per | 40 | 9.130531521208184 | 0.09058565283513512 | 8.223721557853128
n_per | 56 | 9.130266941383212 | 0.09058562168688965 | 8.224041608669427
n_per | 72 | 9.130281247493327 | 0.09058570056611574 | 8.223982254922468
