Loyola-Future-Engineers/Ion-Thruster-Type-EDH/data/verification_torus_convergence.csv

n_per | rel_err | residual
4 | 6.994661195824925e-05 | 0.0009929188060529004
8 | 5.851728764860731e-05 | 1.308942412192593e-05
12 | 5.851350915020426e-05 | 2.249154218425531e-07
16 | 5.851350746133299e-05 | 6.627357773680842e-09
24 | 5.8513507595003844e-05 | 3.988001928689755e-08
32 | 5.851350792940302e-05 | 6.603775237756793e-08
48 | 5.851350849250814e-05 | 8.544931939802325e-08
