Loyola-Future-Engineers/Ion-Thruster-Type-EDH/data/verification_trend_checks.csv

gap_mm | onset_kV | T_per_V | T_per_I | T_per_P
20.0 | 7.765265242227223 | 7.332096457479059e-07 | 93.05693623946179 | 0.00465284681197309
30.0 | 8.133350534533722 | 3.3369214455649907e-07 | 141.45429977769288 | 0.007072714988884645
40.0 | 8.316674710060203 | 1.783233225934385e-07 | 182.69365739186279 | 0.009134682869593139
