Loyola-Future-Engineers/Ion-Thruster-Type-EDH/docs/design_log.md

# Design log: my role and decisions

*To be written by the project author, in their own words. Delete these prompts as you fill them in.*

## Why this project
- What got me interested in ionic-wind / EHD propulsion?
- What was I trying to find out or build?

## My original design idea
- The stacked ring emitter/collector concept, and where it came from.
- My first hypotheses (for example, that stage 1 should have the largest gap).

## Key decisions and why I made them
| Date | Decision | Alternatives considered | Reason |
|---|---|---|---|
| | | | |

## What surprised me
- For example: back-flow between stages mattering more than anything else, or the guard-ring result.

## What I would do differently

## Building and testing log
| Date | What I did | Result / observation | Photo |
|---|---|---|---|
| | | | |
