Loyola-Future-Engineers/Ion-Thruster-Type-EDH/(commit log)

2026-10-28 docs: initialize EHD thruster research framework
    Adds project layout, pinned dependencies, environment record, progress log,
    an axisymmetric charge-simulation electrostatic solver, a reduced-order
    multi-stage device model and verification tests.
2026-10-29 analysis: investigate electrode spacing configurations
    Single-stage gap sweep, two-stage gap/spacing heatmap, equal vs unequal
    gap patterns under common and per-stage supplies, and an exhaustive
    three-stage gap search. Identifies upstream back-flow as the dominant
    stage interaction and records the conditions under which d1>d2>d3 helps.
    [phase_b_gap_patterns.csv, phase_b_heatmap_2stage.csv, phase_b_independent_gaps_3stage.csv, phase_b_single_stage.csv, phase_b_single_stage_fixedV.csv]
2026-10-29 analysis: evaluate ring diameter, collector shape and emitter pin geometry
    Axisymmetric sweeps of collector/emitter diameter, diameter progression,
    collector cross-section and type (torus, washer, tube, mesh), an electric
    field map, and a 3-D charge-simulation pin model covering pin count,
    mutual shielding, orientation and tip radius.
    [phase_c_collector_shapes.csv, phase_c_diameters.csv, phase_e_pin_count_orientation.csv, phase_e_tip_radius.csv]
2026-10-29 analysis: compare two-stage and three-stage configurations
    Thrust-vs-power curves for one, two and three stages under identical
    stage geometry, equal overall length, and low-loss tube collectors, with
    equal-power read-outs and a per-stage back-flow diagnosis.
    [phase_f_equal_power_table.csv, phase_f_stage_curves.csv]
2026-10-29 simulation: perform parameter sensitivity, uncertainty and Pareto analysis
    One-at-a-time tornado sensitivity, paired Monte-Carlo uncertainty across
    stage counts, and a 234-geometry Pareto search for thrust vs efficiency
    and flow vs length.
    [phase_g_monte_carlo.csv, phase_g_monte_carlo_rankings.csv, phase_g_monte_carlo_summary.csv, phase_g_pareto_designs.csv, phase_g_pareto_front.csv, phase_g_sensitivity.csv]
2026-10-29 research: compare electrode material properties
    Analytical resistive-loss and mass calculations, plus a clearly labelled
    qualitative durability/manufacturability assessment of material
    combinations A-J with written reasons and required measurements.
    [phase_d_electrode_mass.csv, phase_d_material_scores_QUALITATIVE.csv, phase_d_resistive_loss.csv]
2026-10-29 docs: establish experimental validation methodology and HV safety
    Test plan prioritised by model assumptions, interference controls,
    GUM uncertainty method with a reduction script that refuses empty
    templates, CSV templates, and a high-voltage safety document.
    [airflow_traverse.csv, configuration.csv, electrode_condition.csv, iv_thrust_sweep.csv, session_log.csv, sparkover_test.csv]
2026-10-29 docs: summarize engineering recommendations and finalize visualizations
    Adds methodology with convergence study and trend checks, engineering
    diagrams, recommendations answering all 16 research questions, README,
    interactive design-space explorer, and regenerated charts with
    consistent provenance footers.
    [verification_device_convergence.csv, verification_torus_convergence.csv, verification_trend_checks.csv]
2026-10-29 simulation: add self-consistent space-charge solver and correct key results
    Axisymmetric Poisson/upwind-drift solver with Kaptsov injection,
    verified against the exact coaxial solution. Quantifies back-flow,
    stage count and housing effects with space charge; updates the spacing
    rule to s >= 3d and flags reduced-model absolute numbers as ~3x high.
    [phase_h_coax_validation.csv, phase_h_spacecharge_cases.csv]
2026-10-29 docs: propagate space-charge corrections to README and recommendations
2026-10-29 cad: add parametric 3-D models of every thruster part
    Thirteen watertight part STLs, 2- and 3-stage assemblies on an insulating
    test stand, interactive viewers, bills of materials with mesh-derived
    masses, section/exterior renders and a pairwise interference check.
    [assembly_2stage.stl, assembly_3stage.stl, base_plate.stl, bom_2stage.csv, bom_3stage.csv, collector_carrier.stl, collector_tube.stl, emitter_carrier.stl]
2026-10-29 docs: title repository Ion Thruster - Type EDH
2026-10-29 docs: polish README, align documents with final results and tidy code
    Restructures the README around the design summary, adds a reading guide,
    marks reduced-model studies with their space-charge corrections, redraws
    section diagrams at the recommended geometry, aligns recommendations with
    the CAD design, and removes unused code.
2026-10-29 prototypes
    Prototype P1 build package: dimensioned fully assembled section, exploded
    stack and per-part drawings coloured by material (stainless needles,
    brass rings and terminals, aluminium collectors, PETG/ASA housing, nylon
    tie rods, PTFE standoffs), 3-D exploded model and viewer, parts and
    materials list, assembly sequence, and blank as-built and performance
    sheets. Design dimensions only; no physical measurements yet.
    [P1_exploded.stl, P1_parts_list.csv]
2026-10-29 Add guard-ring study, project report, licence, CI and cost estimate
    - Guard-ring simulation: a ring at emitter voltage upstream of emitter 2
    removes back-flow (+40 % thrust, 25 % shorter device), proposed for P2
    - 11-page PDF project report generated from the repository results
    - MIT licence and GitHub Actions workflow running the test suite
    - Indicative P1 cost estimate, author/AI credits and design-log template
    [P1_cost_estimate.csv, phase_i_guard.csv]
2026-10-29 Use mm and CAD throughout; add triangular P1x3 cluster and merge joint
    - All lengths in mm and fields in kV/mm across docs, charts, data and report
    - Cost estimate in Canadian dollars
    - Prototype P1x3: three P1 thrusters in an equilateral triangle on a shared
    base plate, plus a 3-into-1 equal-area merge joint, with STLs, viewer,
    renders, dimensioned drawing and interference check
    [P1_cost_estimate.csv, P1_parts_list.csv, P1x3_cluster.stl, P1x3_cluster_with_joint.stl, P1x3_merge_joint.stl, bom_2stage.csv, bom_3stage.csv, phase_e_pin_count_orientation.csv]
2026-10-29 Pack the P1x3 cluster to 60 mm between axes
    Removes the per-thruster tie-rod lugs and clamps the three stacks between a
    shared inlet plate (rounded inlets built in) and a shared top plate with three
    tie rods between the thrusters. HV terminals face outward (34.6 mm minimum
    HV-to-ground clearance). Shorter, lighter merge joint bolted to the top plate.
    [P1x3_cluster.stl, P1x3_cluster_with_joint.stl, P1x3_inlet_plate.stl, P1x3_merge_joint.stl, P1x3_top_plate.stl]
2026-10-29 Final polish: Canadian metric conventions, buildable design, clearer summary
    - SI metric throughout with airflow in L/s; Canadian spelling; CAD costs
    - Gap now measured from the needle tips (fixes a sparkover conflict in the
    CAD); P1 is 173 mm long and 129 g
    - Correct balance sign convention (exhaust up: thrust increases reading)
    - Realistic Canadian sourcing, wiring and balance specification; CSA Z462
    and provincial OHS references in the safety document
    - Rewritten README summary; corrected airflow (1.8 L/s) and guard figures
    - Needle-model charts shown as relative thrust; report reflowed to 10 pages
    [P1_cost_estimate.csv, P1_exploded.stl, P1_parts_list.csv, P1x3_cluster.stl, P1x3_cluster_with_joint.stl, P1x3_merge_joint.stl, P1x3_top_plate.stl, assembly_2stage.stl]
