Loyola-Future-Engineers/Ion-Thruster-Type-EDH/(notices)

Notices in the files:
README.md:
License: MIT
